xonvccna8/hethongtapluyen/RehabBoard_Ket_noi_v2.pdf

# REHABBOARD AI — SƠ ĐỒ KẾT NỐI THEO FIRMWARE (BẢN CẬP NHẬT)

### Cập nhật 05/11/2026 · khớp code trong Firmwave/ và dây thực tế đã test trên board

Test tổng hợp: Firmwave/REHABBOARD_TEST_TONGHOP · thay cho RehabBoard_Ket_noi.pdf

### 01 · ĐO LỰC — 6 LOAD CELL / 6 HX711 (SCK chung GPIO5)

Phím 1 · LC1 · Ngón 1 | ĐỔI: bản cũ GPIO6

HX711 #1

E+
E−
A+
A−

DT → GPIO16

SCK → GPIO5

VCC → 3V3 · GND → GND chung
Phím 2 · LC2 · Ngón 2

HX711 #2

E+
E−
A+
A−

DT → GPIO7

SCK → GPIO5

VCC → 3V3 · GND → GND chung
Phím 3 · LC3 · Ngón 3

HX711 #3

E+
E−
A+
A−

DT → GPIO15

SCK → GPIO5

VCC → 3V3 · GND → GND chung
Phím 4 · LC4 · Ngón 4 | ĐỔI: bản cũ GPIO16

HX711 #4

E+
E−
A+
A−

DT → GPIO6

SCK → GPIO5

VCC → 3V3 · GND → GND chung

Phím 5 · LC5 · Ngón 5 | LỖI: load cell không có tín hiệu

HX711 #5

E+
E−
A+
A−

DT → GPIO17

SCK → GPIO5

VCC → 3V3 · GND → GND chung
Bóp tay · LC6

HX711 #6

E+
E−
A+
A−

DT → GPIO18

SCK → GPIO5

VCC → 3V3 · GND → GND chung

### 03 · XOAY NÚM (ENCODER)

CLK → GPIO13

DT → GPIO12

SW → GPIO11

VCC → 3V3 · GND chung
Code bật INPUT_PULLUP (kéo lên trong chip) ✓ Đã test: xoay 2 chiều + nhấn núm

### 04 · THANH TRƯỢT (BIẾN TRỞ)

SIG (chân giữa) → GPIO9

2 đầu cố định → 3V3 / GND · ADC1, 0–4095
Chạm GND đầu kia → luôn 0 / luôn 4095
⏳ Đã thấy 0 → 3929; cần kéo lại để xác nhận

06 · MÔ-ĐUN 9 LỖ (mục 3 trên poster, thay Kẹp ngón) — 9 CÔNG TẮC ĐÁY LỖ SONG SONG VÀO GPIO10

L1 | L2 | L3 | L4 | L5 | L6 | L7 | L8 | L9
← chân 1 mỗi công tắc → GPIO10 ← chân 2 mỗi công tắc → GND

L1…L9 → GPIO10 (chung)

Cắm chốt / chạm vào lỗ = 1 nhịp nhấn-nhả (LOW). Web đếm 9 lần chạm + bấm giờ Chỉ biết số lần chạm, không biết lỗ nào (muốn biết: mỗi lỗ 1 GPIO riêng)
✓ Đã test: chạm lỗ nào còi cũng kêu (cả 9 công tắc)

### 02 · MÀN HÌNH TFT ILI9341 — SPI PHẦN CỨNG

MISO → GPIO42

SCK → GPIO41

MOSI → GPIO40

DC → GPIO39

RST → GPIO38

CS → GPIO37

### TFT 2.8"

320 × 240 ngang

Màn thực tế 320×240 NGANG (kiểu ILI9342):
code khai báo lại kích thước, không thì sọc nhiễu bên phải VCC / LED → 3V3 (theo bo TFT) · GND chung · Cảm ứng / thẻ SD: chưa dùng Vỏ hộp che ~8 px mép trên, ~25 px mép phải → giao diện vẽ trong 292×232 ✓ Đã test: chữ tiếng Việt, bảng test tổng hợp

### 05 · CÒI (BUZZER)

IN → GPIO19 | Kích MỨC THẤP: LOW = kêu, HIGH = im (code cũ dùng GPIO36 — sai sơ đồ, đã sửa)

VCC theo mô-đun · GND chung
✓ Đã test: kêu khi chạm 9 lỗ, im khi thả

### 07 · GAME PHỤC HỒI — 4 NÚT + 4 LED

NÚT 4 → GPIO36

NÚT 3 → GPIO35

NÚT 2 → GPIO0

NÚT 1 → GPIO45

LED4 → GPIO48

LED3 → GPIO47

LED2 → GPIO21

LED1 → GPIO20

NÚT 1

LED1

NÚT 2

LED2

NÚT 3

LED3

NÚT 4

LED4

Nút ↔ GND (INPUT_PULLUP)
GPIO → R 220 Ω → LED → GND
⚠ GPIO0: không giữ NÚT 2 khi cấp điện/reset ⚠ GPIO45: nút nối GND, không nối 3V3
⚠ GPIO20 = USB gốc: không cắm cổng USB gốc ✓ Đã test: 4 nút · ⏳ 4 LED: chờ xác nhận bằng mắt

### ESP32-S3 DevKitC (cổng CH343 → COM9)

### ESP32-S3

WROOM-1

BOOT | RST
USB (CH343) | USB gốc
3V3 → VCC mô-đun | 3V3

3V3

RST

4

GPIO5 · HX SCK | 5
GPIO6 · DT P4 | 6
GPIO7 · DT P2 | 7
GPIO15 · DT P3 | 15
GPIO16 · DT P1 | 16
GPIO17 · DT P5 | 17
GPIO18 · DT BÓP | 18

8

3

46

GPIO9 · TRƯỢT | 9
GPIO10 · 9 LỖ | 10
GPIO11 · ENC SW | 11
GPIO12 · ENC DT | 12
GPIO13 · ENC CLK | 13

14

5V

GND chung | GND
GND | GND chung

TX

RX

1

2

### 42 GPIO42 · MISO

### 41 GPIO41 · SCK

### 40 GPIO40 · MOSI

### 39 GPIO39 · DC

### 38 GPIO38 · RST

### 37 GPIO37 · CS

### 36 GPIO36 · NÚT 4

### 35 GPIO35 · NÚT 3

### 0 GPIO0 · NÚT 2

### 45 GPIO45 · NÚT 1

### 48 GPIO48 · LED4

### 47 GPIO47 · LED3

### 21 GPIO21 · LED2

### 20 GPIO20 · LED1

### 19 GPIO19 · CÒI

GND

GND

### MÀU DÂY

Đỏ = 3V3 / E+ | Đen = GND / E−
Xanh dương = tín hiệu số / A− | Vàng = clock (SCK)
Xanh lá = ADC / A+ | Cam = ngõ ra (còi, LED)

### THAY ĐỔI SO VỚI BẢN CŨ

1. Phím 1 = GPIO16, Phím 4 = GPIO6 (dây thực tế bị đổi chỗ so với bản cũ)
2. Còi: GPIO19, kích mức thấp (code cũ để GPIO36 — trùng NÚT 4 game)
3. Đủ 6 HX711 (bản code cũ chỉ đọc 5, thiếu Bóp tay GPIO18)
4. Mô-đun 9 lỗ (thay Kẹp ngón): 9 công tắc song song GPIO10 · Encoder kéo lên trong chip
5. TFT là màn 320×240 ngang, chạy SPI phần cứng trên đúng các chân cũ

### TÌNH TRẠNG TEST TRÊN BOARD (05/11/2026)

✓ TFT · Encoder · 9 lỗ + còi · 4 nút game · Phím 1–4 · Bóp tay
⚠ Phím 5: HX711 #5 có dữ liệu nhưng load cell không có tín hiệu → đo E+/E− (~3 V) và điện trở đỏ–đen, xanh–trắng (~1 kΩ)
⏳ Thanh trượt, 4 LED: cần xác nhận lại bằng tay / bằng mắt
- Mục 3 trên poster đổi từ Kẹp ngón sang mô-đun 9 lỗ (GPIO10)
