xonvccna8/hethongtapluyen/RehabBoard_Ket_noi.pdf

# REHABBOARD AI — SƠ ĐỒ KẾT NỐI THEO FIRMWARE

01 · ĐO LỰC — 6 LOAD CELL / 6 HX711 | ESP32-S3

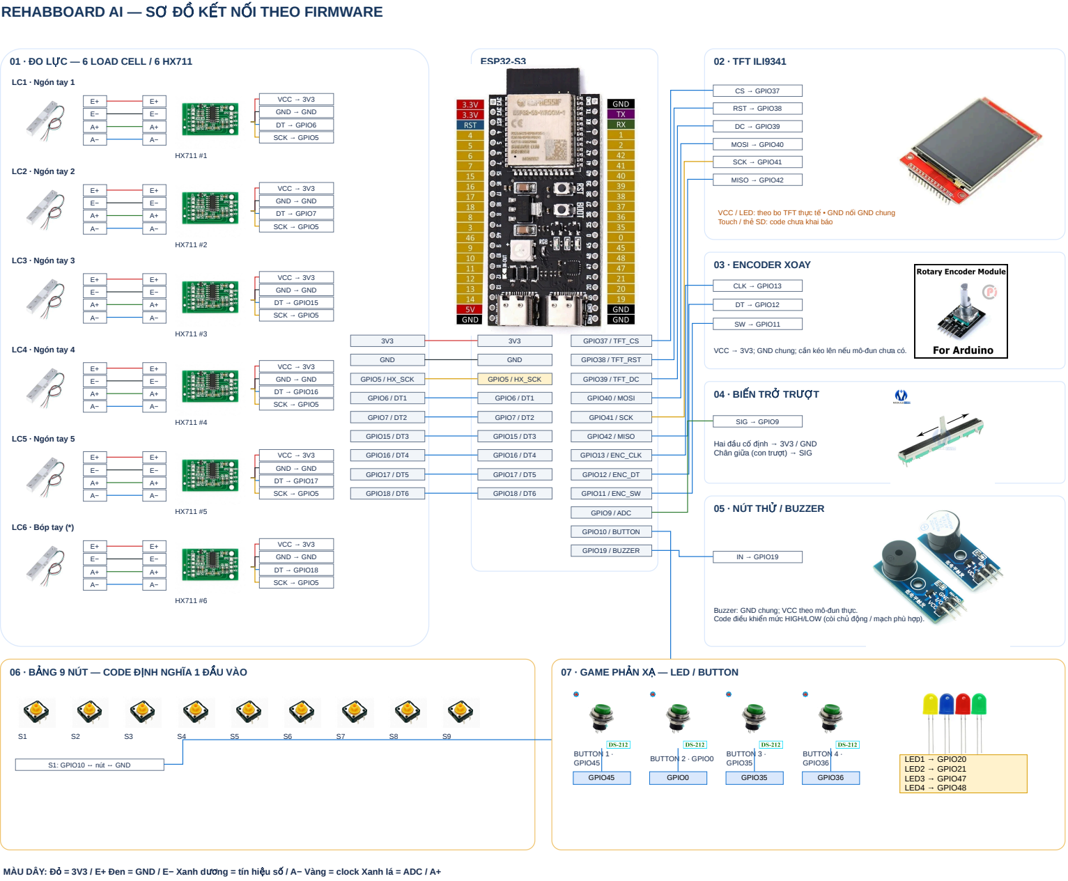
[picture p1: page 1]
GND; GPIO5 / HX_SCK; GPIO6 / DT1; GPIO7 / DT2; GPIO15 / DT3; GPIO16 / DT4; GPIO17 / DT5; GPIO18 / DT6; GPIO37 / TFT_CS; GPIO38 / TFT_RST; GPIO39 / TFT_DC; GPIO40 / MOSI; GPIO41 / SCK; GPIO42 / MISO; GPIO13 / ENC_CLK; GPIO12 / ENC_DT; GPIO11 / ENC_SW; GPIO9 / ADC; GPIO10 / BUTTON; GPIO19 / BUZZER; LC1 · Ngón tay 1; VCC → 3V3; GND → GND; DT → GPIO6; SCK → GPIO5; LC2 · Ngón tay 2; DT → GPIO7; LC3 · Ngón tay 3; DT → GPIO15; LC4 · Ngón tay 4; DT → GPIO16; LC5 · Ngón tay 5; DT → GPIO17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

VCC / LED: theo bo TFT thực tế • GND nối GND chung
Touch / thẻ SD: code chưa khai báo

VCC → 3V3; GND chung; cần kéo lên nếu mô-đun chưa có.

04 · BIẾN TRỞ TRƯỢT

Hai đầu cố định → 3V3 / GND
Chân giữa (con trượt) → SIG

05 · NÚT THỬ / BUZZER

Buzzer: GND chung; VCC theo mô-đun thực.
Code điều khiển mức HIGH/LOW (còi chủ động / mạch phù hợp).

06 · BẢNG 9 NÚT — CODE ĐỊNH NGHĨA 1 ĐẦU VÀO

07 · GAME PHẢN XẠ — LED / BUTTON

MÀU DÂY: Đỏ = 3V3 / E+ Đen = GND / E− Xanh dương = tín hiệu số / A− Vàng = clock Xanh lá = ADC / A+
