xonvccna8/hethongtapluyen/(commit log)

2026-11-05 RehabBoard AI: firmware ESP32-S3, web theo dõi luyện tập + trợ lý AI, sơ đồ đi dây
    - Firmwave/: firmware REHABBOARD_WEB (JSON 20 Hz + lệnh TARE/BEEP/LED), test tổng hợp TFT,
    test từng mô-đun; chân theo dây thực tế đã test 05/11/2026
    - WebApp/: FastAPI + SSE, 6 bài tập (nhấn ngón, bóp tay, 9 lỗ, xoay núm, thanh trượt, game),
    Hand Recovery Score, tiến triển, trợ lý OpenAI (gpt-5.5-mini)
    - SoDo/ + RehabBoard_Ket_noi_v2.pdf: sơ đồ đi dây cập nhật
    - Không đưa lên: WebApp/config.json (API key), WebApp/data/ (dữ liệu người bệnh)
2026-11-05 Triển khai Vercel: giao diện trên Vercel, API về laptop qua Tailscale Funnel
    - vercel.json: phục vụ WebApp/static (trang tĩnh), /static/* -> /*
    - static/config.js: mở từ *.vercel.app thì gọi API về https://laptop-mfdvl03v.tailcce006.ts.net
    - server.py: truy cập từ xa cần mật khẩu (token HMAC, chặn 10 phút sau 5 lần sai),
    CORS chỉ cho *.vercel.app; mật khẩu chỉ xem/đổi được ngay trên laptop
    - Giao diện: màn đăng nhập, báo "máy tính cắm board offline"
2026-11-05 Web nối board trực tiếp qua Bluetooth/USB, AI qua hàm Vercel (bỏ server.py + Tailscale)
    - Firmware REHABBOARD_WEB: Bluetooth LE (NimBLE, tên REHABBOARD): khung nhị phân 34 byte 20 Hz,
    sự kiện JSON, nhận lệnh; tự tắt Bluetooth nếu lần trước sụt áp (nguồn yếu) và chạy tiếp qua USB
    - web/: Web Bluetooth + Web Serial ngay trong trình duyệt, hồ sơ/buổi tập lưu trên máy, sao lưu/khôi phục .json
    - api/ai.js: hàm Vercel gọi OpenAI Responses API (OPENAI_API_KEY, AI_ACCESS_CODE, OPENAI_MODEL)
    - Bỏ WebApp/server.py, CHAY_WEB.bat; vercel.json phục vụ web/
2026-11-05 Vercel: .vercelignore chỉ gửi web/, api/, vercel.json; bỏ qua .vercel/ và .env*
2026-11-05 Luyện tập: nút "Tập đủ 6 bài" (tự dẫn lần lượt, lưu từng bài), hướng dẫn rõ khi nào kết quả được lưu
    - Bấm Dừng giữa chừng báo rõ "CHƯA lưu"; lưu xong ghi tên người tập
    - runExercise()/runAll() tách khỏi nút Bắt đầu
2026-11-05 Nhấn ngón/bóp tay chờ người tập bắt đầu nhấn mới đếm giờ; hỏi xác nhận trước khi tập đủ 6 bài
2026-11-06 App Android (Capacitor) giống web + board BLE nhận 2 thiết bị cùng lúc
    - android-app/: đóng gói nguyên web/ thành APK; src/native-ble.js dựng lại
    navigator.bluetooth bằng Bluetooth LE gốc Android (web/app.js không đổi),
    /api/ai gọi về Vercel qua CapacitorHttp, ẩn nút USB, chừa chỗ thanh hệ thống,
    icon bàn tay. Quét BLE không cần vị trí (BLUETOOTH_SCAN neverForLocation).
    - Firmware: vẫn phát sóng khi đã có 1 thiết bị nối (tối đa 2: app điện thoại +
    web laptop), phát lại ngay khi ngắt; TFT hiện số thiết bị đang nối.
2026-11-06 Giao diện điện thoại: Game phục hồi không còn tràn ngang
    - 4 đèn co giãn theo bề ngang (máy tính 84px, điện thoại ~60px), luôn tròn, 1 hàng như trên board
    - Đèn sáng tô màu đặc + quầng sáng cùng màu (biến --lc), dễ nhận ra
    - runner-body dùng minmax(0,1fr) để sân khấu không đẩy bảng điều khiển ra ngoài
    - Trên điện thoại: pha bên trái, số đếm bên phải, nút Bắt đầu/Dừng to chiếm cả hàng
